vyges/sg13cmos5l_vyges_ip__pll_rosc/README.md

# sg13cmos5l_vyges_ip__pll_rosc

Ring-oscillator **PLL** for the IHP **SG13CMOS5L** process — a self-biased,
dual-control-path ring-VCO PLL with a register-selectable ÷N feedback divider.
**All-CMOS** (no SiGe HBT / MiM cap / deep-N-well / Schottky — none of which
SG13CMOS5L provides); the loop-filter cap is MOM/poly within the 5-metal stack.
Built for the **Chipalooza Challenge #2 (IHP SG13CMOS5L)** as an openframe
analog-slot IP.

> Status: **laid out and handed off to the harness (`gds/`); post-layout check done on the handed-off block.**
> The block is its own layout cell, instanced once in `gds/slot_6.gds`; both are DRC-, antenna- and
> LVS-clean on the PDK decks, with all control bits pinned, and the harness test build places it.
> Post-layout (extracted C, no wire R yet), phase margin passes (46.2° against 45°) and lock at
> the typical corner is 18 µs. The ring runs about 23 % slower than in the schematic, and lock at
> ss / −40 °C / 1.08 V is 24 µs against a 20 µs goal. Measured on the handed-off block itself
> (2026-10-19). See [`doc/implementation.md`](doc/implementation.md)
> for what is built and measured, and [`doc/proposal.md`](doc/proposal.md) for the original
> design intent.

PLL top level

The loop: a tri-state PFD (`Xup`/`Xdn`, reset through `Xnand`/`Xand`, held by `porb`) steers the
charge pump's switches `Mswup`/`Mswdn` between the current source `Mpsrc` and sink `Mnsnk`; the
pump drives `vctrl` into `Cp` and the `Rz`–`Cz` zero; `vctrl` sets the current-starved ring
`Xvco`, whose output returns through the ÷N divider `Xdiv`. The figures in
[`doc/figures/`](doc/figures/) are drawn from the xschem schematics and checked against them pin
by pin (the check tables are in that directory's README); the schematics in `xschem/` remain the
source of truth.

| PFD | Charge pump | Ring VCO: one stage, and the folded seven-stage ring |
| --- | --- | --- |
| PFD | Charge pump | Ring VCO |

## Summary

Measured on the schematic hierarchy and, post-layout, on the routed slot-6 layout with extracted
capacitance (no wire resistance yet), on the 1.2 V core rail this block is specified for.

| Parameter | Schematic | Post-layout | Goal |
| --- | --- | --- | --- |
| Digital supply (`vccd`) input | **1.08 / 1.20 / 1.32 V** — the 1.2 V ±10 % core rail, a hard input. Arrives on the block's `vdd` port. **Not** the 3.3 V pallet supply, which this block does not use | same | 1.08–1.32 V |
| Reference in | 16–50 MHz usable | 16–33 MHz at ÷8 guaranteed over PVT (ceiling ÷ 8) | 10–50 MHz |
| Output, typical corner | 115.4–735.3 MHz | 197.5–565.4 MHz | 100–800 MHz |
| Output, guaranteed over PVT | **352.6 MHz** ceiling, within charge-pump compliance | **267.1 MHz** | 800 MHz |
| Divider | ÷8 and ÷16 usable (÷2, ÷4 need a reference above 50 MHz) | same | N = 4…64 |
| Lock time, typical | **16.0 µs** (tt / 27 °C / 1.20 V) | **18 µs** ✅ | 20 µs max |
| Lock time, worst measured corner | **24.0 µs** ❌ (ss / −40 °C / 1.08 V) | **24 µs** ❌ | 20 µs max |
| Phase margin, N = 8 | **51.3°** ✅ (ff / 27 °C / 1.32 V / worst-case sheet) | **55.8°** ✅ | 45° min |
| Phase margin, N = 16 | **51.2°** ✅ (ss / 27 °C / 1.08 V / best-case sheet) | **46.2°** ✅ | 45° min |
| Crossover vs f_ref/10 | **1.20×** — exceeds the guideline | **1.01×** | ≤ 1.0 |
| Charge-pump current | **0.31–0.63 µA** measured, from the harness 250 nA reference | — | — |
| Loop filter | Rz 125.09 kΩ, Cz 8.65 pF (82 × 82 µm), Cp 0.33 pF (16 × 16 µm) | Cz 8.57 pF, Cp 0.33 pF extracted (−1 %) | — |

Every figure in this table is derived by `tools/datasheet.py`, which **exits non-zero if any
published number has drifted from the simulation behind it** — so the table cannot quietly go
stale. The post-layout column is checked against `doc/datasheet/pll_rosc_pex.md`, which the
same tool writes from the post-layout run (`--source pex --tree <run> --pexjson <pex_cells.json>`).
Post-layout lock time is sampled every 6 µs (48 µs window): typical lock lands between 12 and
18 µs, and the worst corner between 21 and 24 µs (a 24 µs run with 3 µs samples was still 9 % short at 21 µs). Detail, and what each miss costs, below.

## What it is

A foundational on-chip clock multiplier. Designed to drop into one openframe pallet slot —
**allocated slot 6, two pins**, which is exactly what it asks for: `ref` in and `vco_out` out.
It runs entirely from the **1.2 V core rail**, takes its bias from the harness 250 nA current
reference, and receives ÷N-select and its two resets as a register field on the digital
control-status bus. It needs **no 3.3 V analog rail**, and it reports no status: lock detect
is not implemented.

The loop figures come from a closed-loop run with every block real except the VCO, which is
behavioural and matched to the measured tuning curve of the real ring.

🔑 **The goals column is a goal, not a contract.** It was written before the PDK, the charge
pump's real output current and the supply's own tolerance could be modelled. They can be now,
and the measured column is what this design does on a 1.2 V rail. The output ceiling is the
clearest case: the ring reaches 735 MHz at the typical corner with the control voltage at the
top of the pump's compliance range, so 800 MHz guaranteed is not a margin that can be tuned
back — it is a property of a seven-stage ring on this process at this supply.

✅ **Phase margin passes at both divider settings**, 51.3° and 51.2° against a 45° floor,
over every operating point the part can be commanded into. Getting there needed two things
that had never been measured rather than any change to the oscillator:

- **The charge-pump current.** It was carried as 1 µA because the pump mirrors the harness
  bias 1:1. The mirror is 1:1 in *width*, not in drain-source voltage — measured over 27
  corners it delivered **1.16–2.26 µA**, so the loop ran at roughly twice the gain its filter
  was designed for. The block now takes the harness **250 nA** reference instead, measuring
  0.31–0.63 µA; required filter capacitance scales with it, so this also made the fix cheap
  (6,980 µm² of capacitor against 15,908 µm² at the 1 µA rail).
- **The top of the control range is not an operating point.** The pump's up branch runs out
  of compliance at about 0.85–0.91 × vdd and collapses to zero at the rail, so tuning-curve
  points above that cannot hold lock. The lowest Kvco in the whole sweep lives there, and it
  had been setting the phase-margin worst case.

📏 **Acquisition, per corner.** The bench models the ring behaviourally at one corner, so the
spread is measured explicitly rather than inferred — transistor-level, 100 ps over a 32 µs
window, at the corners with the lowest loop gain at the lock point:

| Corner | Lock time | |
| --- | --- | --- |
| tt / 27 °C / 1.20 V | 16 µs | ✅ |
| ss / 110 °C / 1.08 V | 16 µs | ✅ |
| ss / 27 °C / 1.08 V | 20 µs | ✅ at the limit |
| tt / −40 °C / 1.08 V | 20 µs | ✅ at the limit |
| **ss / −40 °C / 1.08 V** | **24 µs** | ❌ |

⛔ **One corner of the specified set misses the 20 µs goal** — cold, slow process, bottom of
the rail. At 20 µs it is still 3 % from its lock point, so this is a real miss and not a
sampling artifact. It is a direct consequence of bringing the loop inside its own bandwidth
bound: the previous 4 µs was fast *because* the crossover sat at twice the f_ref/10 it
claimed. Four corners were measured, not twenty-seven — each is a multi-hour transient, so
they were chosen by loop gain at the lock point and the rest are inference from them.

⚠️ **What is not met, stated here rather than left to be found.** The **output ceiling**,
above. The **divider range**, since only ÷8 and ÷16 are usable against a 16–50 MHz reference.
And the **crossover bound**: the loop's crossover reaches 1.20 × f_ref/10 at worst case
(N = 8, worst-case sheet, ff/27 °C/1.32 V), against the classical ≤ f_ref/10 guideline — 11 of
456 corner/point combinations exceed it, all at N = 8 and worst-case sheet resistance, by at
most 20 %. It is published as measured rather than bought back, because the only lever that
lowers it is a faster loop, and acquisition time is the tighter constraint. Six further
specifications — period and RMS jitter, phase noise, reference spur, duty cycle and power —
are **not measured**, for the one reason given in
[`doc/implementation.md`](doc/implementation.md). Lock detect and the output post-divider are
**not implemented**.

⛔ **Supply rails, because these have been conflated more than once.** **1.2 V is the core
rail and this block runs entirely from it** — ring, PFD, charge pump and divider are all lv
devices and 1.2 V standard cells. **3.3 V is the pallet supply** from the harness pMOS power
switch, and this block does not use it at all. The corner set is **1.08 / 1.20 / 1.32 V**,
which is what the PDK characterises (`sg13cmos5l_stdcell_*_1p08/1p20/1p32`); an earlier sweep
of 0.98 / 1.20 / 1.50 V was neither — 0.98 V is *below* the slowest characterised standard
cell, and 1.50 V is the other rail family's nominal. Detail and the traps that caused it:
[`doc/implementation.md`](doc/implementation.md).

## For the integrator

[`doc/implementation.md`](doc/implementation.md) carries two sections written for scoping
this block into a slot:

- **Supply rails** — which rail is which, why the corner set is 1.08/1.20/1.32 V, and the three ways 1.2 V and 3.3 V have been conflated here before.
- **Assumptions** — the process and harness resources the design rests on, each with what it is based on.
- **Slot requirements** — pads, harness resources, control bits and clocks. Two pads, one
  of them an up-to-735 MHz output that needs a dedicated path; the block runs entirely
  from 1.2 V, with **no 3.3 V analog rail required**.
- **Against the proposal** — every goal line with what the schematic measures, including the
  output range and divider range that fall short of it.

## Physical design

✅ **The layout is in [`gds/`](gds/).** Every device of the netlist is placed in the slot-6
floorplan ([`doc/implementation.md`](doc/implementation.md#floorplan--the-slot-6-placement-as-checked-data)).
The block is its own cell, `sg13cmos5l_vyges_ip__pll_rosc` (529.05 × 269 µm, pins named by its
ports), routed inside its own outline; `gds/slot_6.gds` instances it once in the harness slot,
with a straight stub from each wrapper pin it uses to the block pin facing it. On the PDK decks:

| Check | Block alone | In `slot_6` |
| --- | --- | --- |
| DRC (KLayout, main rules) | **0** | **0** |
| Antenna | **0** | **0** |
| LVS (KLayout, strict top-level ports) | **match** | **match** |
| Unused wrapper pins clear of our metal | — | **0 violations, 45 pins** |
| Density | fails at block level, as expected — chip-level fill is a harness step | |

In the harness's own test build, the slot is found and placed, its outline and every pin land on
the wrapper's (contract check PASS), and the slot as assembled into the chip is identical to
`gds/slot_6.gds` (XOR clean, 36 layers).

**Antenna diodes** (2026-10-18): `ref` and `porb` arrive from wrapper pins hundreds of µm away and
climb to TopMetal1, so the PFD gates they drive failed the antenna rule on Metal3, Metal4 and
TopMetal1 (12 markers). One `sg13cmos5l_antennanp` beside each gate, in the schematic and the PFD
region, clears all 12; the pad's ESD diode could not, because it joins only on Metal3.

`Rz` is drawn **straight** (1.40 × 89.22 µm). Folding it with the PDK's `rhigh` serpentine would
change what LVS extracts (per-segment `l`, bends, leg spacing) and the resistance itself.

**The ring is folded.** The first layout placed the seven stages in one row and wrapped it
partway through one stage, so one ring wire ran about 110 µm back across the block. The ring
now runs in two lanes, one column per stage, with each stage's load inverter in its own column,
so no ring wire spans more than about one column. Ring-node capacitance went from 2.1–12.3 fF to
an even 3.2–5.8 fF.

**Post-layout (capacitance only; wire resistance is not yet extracted):**

| | Schematic | First layout | Folded ring |
| --- | --- | --- | --- |
| Ring frequency, tt / 27 °C / 1.20 V, vctrl 0.80 V | 421.4 MHz | 296.0 MHz (−30 %) | 319.7 MHz (−24 %) |
| Worst phase margin, N = 16 (floor 45°) | 51.2° | ⛔ 44.4° | ✅ 46.0° |
| Lock at ss / −40 °C / 1.08 V (goal 20 µs) | 21.0 µs | ⛔ unreachable (control voltage above the pump's compliance) | ⛔ 21–24 µs |

The loop filter extracts within 1 % of the model, so the filter is not the cause. The rest of the
slowdown is the minimum wiring each ring node needs (about 4 fF against about 15 fF of device
load). The folded ring gets back enough of it to pass the phase-margin floor, with 1° to spare.

**Lock with the folded ring.** In a 48 µs run, the control voltage reaches its lock point
(0.891 V) at 24 µs and stays within 0.13 % of it to the end. In a 24 µs run sampled every 3 µs,
it is still 9 % short at 21 µs. So lock lands between 21 and 24 µs, and it misses the 20 µs goal
at this corner. The schematic misses too: 21.0 µs on the same 3 µs grid, and 24 µs in its own
32 µs run (see Acquisition, per corner). The miss comes from the loop sizing; the layout makes it
slightly worse. Closing it means faster loop dynamics, which costs phase margin, and post-layout
margin is now 46.0° against a 45° floor. So it is a spec decision, not a layout fix: either relax
lock time at cold, slow process, low rail, or retune the loop and re-check phase margin.

Open items:

- ✅ **Post-layout check re-run on the handed-off block (2026-10-19).** Giving the block its own
  outline moved the routing grid, so every net was re-routed (same placement, wire length 5585
  against 5575 µm). The table above is that block's: phase margin 55.8° (÷8) and 46.2° (÷16),
  tuning 197.5–565.4 MHz typical, lock 18 µs typical and 24 µs at ss / −40 °C / 1.08 V.
- ⚠️ **The PFD's antenna diodes needed a simulation workaround.** The PDK's `dantenna` model
  aborts a transient under a clock edge
  ([IHP-Open-PDK#1288](https://github.com/IHP-GmbH/IHP-Open-PDK/issues/1288)). The cause, per the
  maintainer, is the soft-breakdown fit: `nbv` ≈ 49 makes the reverse current jump about 160× at
  3·n·kT/q (78 mV at 27 °C), and the model's 700 ns transit time amplifies the jump.
  - **Workaround:** the PFD benches include a copy of the PDK's `diodes.lib` with the transit time
    and the 0.36 MΩ series resistance removed (`sim/diodes_rev.sh`).
  - **Why it is safe:** the diodes stay reverse-biased, where neither parameter does anything. The
    lock bench agrees with the same bench run without the diodes to 0.8 mV of `vctrl` at every
    sample.
  - **Upstream's fix agrees:** the maintainer's breakdown fix gives the same result as this
    workaround, within 0.5 mV, wherever both run.
- ⛔ Lock at ss / −40 °C / 1.08 V misses 20 µs (a spec decision). Then the same check with wire resistance extracted.
- ✅ **Control bits pinned (2026-10-08):** `nsel0` → `dig_in[0]`, `nsel1` → `dig_in[2]`,
  `rstb` → `dig_in[4]`, `porb` → `dig_in[6]` of slot 6's own 24-bit `dig_in` bus. Every other
  bit is used, so the router has a gap to reach each 0.22 µm pin. The wrapper's unused pins go to
  the router as blockages and are checked after routing. Routed DRC 0, LVS match. If the bits
  power up at 0, `porb` and `rstb` hold the phase detector and divider in reset until software
  releases them.
- ⚠️ `vco_out` keeps its analog pad, and an on-slot output divider is added (decided
  2026-10-05). The divider is not drawn yet.
- ℹ️ In the taped-out layout the rails are routed as ordinary nets. The supply grid is on the
  `layout-refine` branch (below).

### Layout refinement (branch `layout-refine`, in progress)

The tables above describe the taped-out layout (tag `tapeout-2026-10`). This branch carries the
items from the layout review. Its numbers are short checks only; the full post-layout gate runs
once the refinements are done.

- **Supply grid.** vdd and vss run as TopMetal1 bands over Metal4 fingers, fed from spines at the
  block edges. Each supply terminal is joined to its band by a drawn via stack instead of being
  left to the router.
- **Tie cell.** The PFD flops' D inputs are driven by a tie-high cell (`dhi`), not the vdd rail.
  With the grid on vdd, those two gates were the only gate area on a net with thousands of µm² of
  metal, and the antenna rule failed.
- **Guard rings.** Every analog region has a p+ substrate ring; the charge pump and the VCO also
  have an n+ well ring.
- **Compaction.** The regions take 11.5 % of the slot (was about 22 %). The VCO's fold is
  mirrored so that its output end (X1, X7 and the output buffer) sits by the `vco_out` pad;
  before, the buffer was about 230 µm from it.

Short check (tt / 27 °C / 1.20 V; capacitance only): DRC 0, antenna 0, LVS match, keepouts 0. The
tuning curve tops out at 539.9 MHz against 565.4 MHz for the taped-out layout (−4.5 %): ring nodes
n2–n5 each gained 0.8–1 fF of routed Metal3. Drawing the ring wiring by hand is the next step for
that.

**What routing needed that the PDK cells do not provide:** a gate contact on every MOSFET, a well
tap on every pMOS, a substrate tie beside every nMOS (LU.b), and short Metal4 stubs to bring
each MOM capacitor's minimum-width terminal pins out of a cell that fills Metal1–Metal4.
Reported upstream as [IHP-Open-PDK#1267](https://github.com/IHP-GmbH/IHP-Open-PDK/issues/1267);
newer PDK versions add a guard-ring option that covers the taps and ties.

## Layout

| Dir | Contents |
| --- | --- |
| `xschem/` | schematics — `cs_inv`, `rosc_vco`, `pfd`, `charge_pump`, `loop_filter`, `divn`, `pll_rosc` |
| `doc/schematics/` | rendered SVGs of every cell, readable without opening xschem |
| `gds/` | the layout: block cell `sg13cmos5l_vyges_ip__pll_rosc` and the harness hand-off `slot_6.gds` |
| `doc/figures/` | presentation circuit figures (cirfig_gen), each checked pin by pin against the schematic |
| `netlist/` | extracted / simulation netlists |
| `sim/` | testbenches — **`sim/ringvco_feasibility.spice`** + `run_tuning_sweep.sh` |
| `verilog/` | digital control/status wrapper (LibreLane) |
| `signoff/` | DRC / LVS / extract / STA reports |
| `doc/` | design notes, characterization |

## Toolchain

IHP open flow: **xschem / ngspice / magic / netgen / klayout** + **LibreLane**
for digital. ngspice must support **OSDI v0.4** (the IHP PSP103 models —
SG13CMOS5L shares them with SG13G2) — use IIC-OSIC-TOOLS or ngspice ≥ 43.

[**Vyges Loom**](https://vyges.com/products/loom) provides independent sign-off
alongside it — `vyges loom lvs` gates connectivity against a known-good netlist,
`vyges loom extract` supplies parasitics once there is layout, and `vyges loom meas`
measures swept transfers. Each exits non-zero on a violation, so they run as build
gates. Install: <https://docs.vyges.com/installation.html>. Commands and results are
in [`doc/implementation.md`](doc/implementation.md).

## Reproducing the results

`sim/run.sh` netlists the schematic hierarchy and runs every testbench from a clean
clone. It needs xschem, ngspice, and the IHP PDK — **one checkout now covers both halves**,
since upstream merged the `ihp-sg13cmos5l` overlay into IHP-Open-PDK:

```sh
git clone --branch dev --recurse-submodules https://github.com/IHP-GmbH/IHP-Open-PDK.git
git -C IHP-Open-PDK checkout ab1510cbdcbd61fe82e24ec28179c02ea7083299
PDK_ROOT=$PWD/IHP-Open-PDK python3 IHP-Open-PDK/ihp-sg13g2/libs.tech/ngspice/install.py
PDK_ROOT=$PWD/IHP-Open-PDK PDK=ihp-sg13cmos5l sh sim/run.sh
```

`--recurse-submodules` is not optional, and `install.py` compiles the Verilog-A models
(`psp103`, `psp103_nqs`, `r3_cmc`, `mosvar`) that ship as sources rather than binaries.

⚠️ **One upstream gap to work around.** Both `.spiceinit` files load all six OSDI models
from `$PDK_ROOT/$PDK/libs.tech/ngspice/osdi/`, but `install.py` writes its four only into
`ihp-sg13g2`, while `ihp-sg13cmos5l` ships only the other two (`cap_cmomf`, `cap_cmomi`)
prebuilt. Neither directory holds all six, so whichever `$PDK` you select the elaboration
fails on the missing pair. Symlink the two sets into each other after installing.

`$PDK_ROOT` defaults to `/foss/pdks` (what IIC-OSIC-TOOLS sets) and `$PDK` to
`ihp-sg13g2`, so the bundled PDK still works — but it is the *old* two-repository pin and
will not reproduce the numbers above.

⛔ **A PDK missing `cap_cmomf` does not fail — it silently drops every capacitor.** For a
symbol it cannot resolve, xschem writes `*  Cz -  cap_cmomf  IS MISSING !!!!` as a
*comment*: the netlist stays syntactically valid and simulates. The IIC-OSIC-TOOLS bundled
PDK still ships the pre-rename `cap_mfringe` and no `cap_cmomf` at all, so the loop filter
netlists against it as a bare resistor with both capacitors gone. ⟹ Grep a fresh netlist for
`IS MISSING` before trusting anything derived from it.

Apache-2.0. See [`NOTICE`](NOTICE) for attribution.
