vyges/sg13cmos5l_vyges_ip__pll_rosc/gds/README.md

# Layout

| File | Top cell | Size (µm) | What it is |
| --- | --- | --- | --- |
| `sg13cmos5l_vyges_ip__pll_rosc.gds` | `sg13cmos5l_vyges_ip__pll_rosc` | 529.05 × 269.00 | The PLL as a reusable block: its own prBoundary, pins named by its ports (`ref`, `vco_out`, `ibias`, `nsel0`, `nsel1`, `rstb`, `porb`, `vdd`, `vss`) |
| `slot_6.gds` | `slot_6` | 537.15 × 273.00 | The Chipalooza slot 6 hand-off: one instance of the block at (4, 2), the wrapper pins it uses, and a straight stub from each to the block pin facing it |

This is the `layout-refine` layout (2026-10-26): supply grid, guard rings, compaction and the mirrored ring
fold. The taped-out layout (2026-10-18) is the one on `main`.

Checks on both files (2026-10-26, IHP-Open-PDK KLayout decks, block alone and in the slot):
DRC 0, antenna 0, LVS match, and every unused wrapper pin clear of our metal.
Generated by chipalooza `tools/slot_route_run.sh 6` from the xschem schematic in `xschem/`.
