vyges/sg13cmos5l_vyges_ip__pll_rosc/doc/figures/README.md

# PLL presentation figures

Last updated: 2026-10-18

Slide figures for `pll_rosc`, drawn with cirfig_gen (one SVG per figure, sized in pt; insert at
100 % and never resize). Each figure has its SVG, the editable JSON layout, and a PNG preview.

**These figures are drawn from descriptions. The xschem schematics in `xschem/` are the source of
truth.** The xschem exports in `doc/schematics/` are unchanged. Checked against the schematics at
commit `bfc61e8` (which added the `pfd` antenna cells).

| Figure | Size (pt) | What it shows |
|---|---|---|
| `pll_top.svg` | 885.46 x 412.01 | Loop: PFD (`Xup`, `Xdn`, `Xnand`, `Xand`), charge pump (`Mpsrc`, `Mswup` with its `up` inverter, `Mswdn`, `Mnsnk`), loop filter (`Rz`, `Cz`, `Cp`; the top instantiates `loop_filter`, not `loop_filter_lownoise`), ring VCO `Xvco`, divider `Xdiv`. |
| `pll_pfd.svg` | 402.32 x 260.86 | `pfd`: two DFFs with D tied high, clocked by ref and div; `rstb` = AND(NAND(up, dn), porb) resets both (active-low RESET_B). |
| `pll_cp.svg` | 508.61 x 325.06 | `charge_pump` transistor level: ibias mirror `Mn0`/`Mn1`/`Mnsnk`, `Mp0` -> `vbp` -> `Mpsrc`, switches `Mswup` (gate `upb` from `Mpi`/`Mni`) and `Mswdn` (gate dn) onto vctrl. |
| `pll_vco.svg` | 795.34 x 318.42 | Left: one current-starved stage `cs_inv` (`Mps`, `Mpu`, `Mnd`, `Mns`; shown as stage X1, in = n1, out = n2) with the shared bias `Mpr`/`Mnr` (vctrl -> vbp). Right: the 7-stage ring drawn folded (X1-X4 left to right, X5-X7 back), n1 tapped by `Xtap` (inv_1) and `Xbuf` (inv_4) to vco_out. |

## Drawing conventions

- The VDD symbol is `vdd`; the GND symbol is `vss`. Bulk terminals are not drawn (PMOS bulk vdd, NMOS bulk vss throughout).
- Terminal labels name schematic nets: REF=ref, DIV=div, UP=up, DN=dn, PORB=porb, VCTRL=vctrl, IBIAS=ibias,
  IN/OUT = the stage's in/out, VCOOUT=vco_out. The free labels `rstb`, `div` and `n1` name internal nets.
- The DFF symbol's R pin is the cell's active-low RESET_B. The cells' Q_N outputs (nets upn, dnn) connect
  to nothing in the schematic and are not drawn.
- Since `bfc61e8`, the PFD's D inputs are driven by a tie-high cell `Xtiehi` (node `dhi`), not the
  vdd rail. The flops still see a constant 1, and the figures show D tied high. The cell is in
  `doc/schematics/pfd.svg`.
- The folded ring follows the placement described in `doc/implementation.md` (X1-X4 one way, X5-X7 back); electrically it is the plain ring n1 -> X1 -> ... -> X7 -> n1.

## Simplifications

- `pll_top.svg`: the pump's `Mpsrc` and `Mnsnk` are drawn as current sources (they are the mirror outputs;
  the mirror `Mn0`/`Mn1`/`Mp0` and the ibias input are in `pll_cp.svg`); `Mpi`+`Mni` are drawn as one inverter.
  **`Xdiv` is drawn with the palette Buffer symbol as a stand-in**, labelled "1/N, N=2,4,8,16": the palette has
  no divider block, and the divider (four ripple DFFs with Q_N fed back to D, plus a mux4 selecting the tap)
  cannot be drawn at cell level without a crossing per stage. Its rstb, nsel0 and nsel1 inputs are not drawn.
  The VCO uses the palette Ring Oscillator icon, which has no leads: vctrl ends on the ring's left point and
  vco_out leaves its bottom point, so both wires cross the icon's tinted margin.
- `pll_top.svg` has two wire crossings (no dots), both in the PFD reset loop: once the PFD outputs continue
  into the pump, `rstb` cannot reach both RESET_B pins without crossing the dn line once and the lower NAND
  input tap once. `pll_pfd.svg` on its own has no crossings.
- Not drawn: the antenna-protection cells `Xantref` (on ref) and `Xantporb` (on porb) in `pfd`, and the
  six matched dummy inverters `Xdum2`-`Xdum7` (inv_1 on n2-n7, outputs open) in `rosc_vco`.

## Verification

Each table below was generated by extracting connectivity from the `.sch` geometry (instance pin
positions from the PDK/local symbols, nets from the xschem wire labels; hierarchical figures are checked
against the top schematic flattened one level) and comparing it, pin by pin, with the connectivity of
the figure's own wires. The same extractor reproduces the LDO's xschem netlists exactly. A figure passes
only when every drawn pin lands on the schematic net, no figure net joins two schematic nets, no
schematic net is split (except supplies), and every schematic device is either drawn or listed as not
drawn. A drawn symbol that stands for several devices is checked on its ports, as a pseudo-device:
`Xcp/Mpi+Mni` (A=up, Y=upb), `Xvco` (vctrl in, vco_out out), `Xdiv` (clk in, div_out out).

Render check (`tools/render.py`): every figure reports "all wire ends on pins or wires".

#### Check: pll_top.svg vs xschem/pll_rosc.sch (flattened one level)

Devices: schematic 45 instances (flattened one level, including the hierarchy wrappers), drawn 14 symbols, three of which stand for device groups (the pump inverter = Mpi+Mni; Xvco; Xdiv); not drawn: Xpfd (wrapper); Xpfd/Xantref (antenna cell on ref); Xpfd/Xantporb (antenna cell on porb); Xcp (wrapper); Xcp/Mn0 (ibias mirror (in pll_cp.svg)); Xcp/Mn1 (ibias mirror); Xcp/Mp0 (ibias mirror); Xcp/Mpi (drawn as the inverter); Xcp/Mni (drawn as the inverter); Xlf (wrapper); Xvco/ (ring internals, in pll_vco.svg); Xdiv/ (divider internals (4 ripple DFFs + mux4), shown as one stand-in symbol).

| Figure symbol | Schematic device | Pin | Schematic net | Figure net | Match |
|---|---|---|---|---|---|
| Xup | Xpfd/Xup | D | vdd | VDD symbol | yes |
| Xup | Xpfd/Xup | CLK | ref | REF (terminal) | yes |
| Xup | Xpfd/Xup | Q | up | internal node | yes |
| Xup | Xpfd/Xup | RESET_B | Xpfd/rstb | internal node | yes |
| Xdn | Xpfd/Xdn | D | vdd | VDD symbol | yes |
| Xdn | Xpfd/Xdn | CLK | div_out | internal node | yes |
| Xdn | Xpfd/Xdn | Q | dn | internal node | yes |
| Xdn | Xpfd/Xdn | RESET_B | Xpfd/rstb | internal node | yes |
| Xnand | Xpfd/Xnand | A | up | internal node | yes |
| Xnand | Xpfd/Xnand | B | dn | internal node | yes |
| Xnand | Xpfd/Xnand | Y | Xpfd/nout | internal node | yes |
| Xand | Xpfd/Xand | B | porb | PORB (terminal) | yes |
| Xand | Xpfd/Xand | A | Xpfd/nout | internal node | yes |
| Xand | Xpfd/Xand | X | Xpfd/rstb | internal node | yes |
| Xcpinv | Xcp/Mpi+Mni | A | up | internal node | yes |
| Xcpinv | Xcp/Mpi+Mni | Y | Xcp/upb | internal node | yes |
| Mswup | Xcp/Mswup | G | Xcp/upb | internal node | yes |
| Mswup | Xcp/Mswup | D | vctrl | internal node | yes |
| Mswup | Xcp/Mswup | S | Xcp/a | internal node | yes |
| Mswdn | Xcp/Mswdn | G | dn | internal node | yes |
| Mswdn | Xcp/Mswdn | D | vctrl | internal node | yes |
| Mswdn | Xcp/Mswdn | S | Xcp/b | internal node | yes |
| Ipsrc | Xcp/Mpsrc | S | vdd | VDD symbol | yes |
| Ipsrc | Xcp/Mpsrc | D | Xcp/a | internal node | yes |
| Insnk | Xcp/Mnsnk | D | Xcp/b | internal node | yes |
| Insnk | Xcp/Mnsnk | S | vss | GND symbol | yes |
| Rz | Xlf/Rz | P | vctrl | internal node | yes |
| Rz | Xlf/Rz | M | Xlf/nz | internal node | yes |
| Cz | Xlf/Cz | c0 | Xlf/nz | internal node | yes |
| Cz | Xlf/Cz | c1 | vss | GND symbol | yes |
| Cp | Xlf/Cp | c0 | vctrl | internal node | yes |
| Cp | Xlf/Cp | c1 | vss | GND symbol | yes |
| Xvco | Xvco | vctrl | vctrl | internal node | yes |
| Xvco | Xvco | vco_out | vco_out | VCOOUT (terminal) | yes |
| Xdiv | Xdiv | clk | vco_out | VCOOUT (terminal) | yes |
| Xdiv | Xdiv | div_out | div_out | internal node | yes |

Net check: PASS

#### Check: pll_pfd.svg vs xschem/pfd.sch

Devices: schematic 6, drawn 4; not drawn: Xantref (antenna-protection cell on ref, not drawn); Xantporb (antenna-protection cell on porb, not drawn).

| Figure symbol | Schematic device | Pin | Schematic net | Figure net | Match |
|---|---|---|---|---|---|
| Xup | Xup | D | vdd | VDD symbol | yes |
| Xup | Xup | CLK | ref | REF (terminal) | yes |
| Xup | Xup | Q | up | UP (terminal) | yes |
| Xup | Xup | RESET_B | rstb | internal node | yes |
| Xdn | Xdn | D | vdd | VDD symbol | yes |
| Xdn | Xdn | CLK | div | DIV (terminal) | yes |
| Xdn | Xdn | Q | dn | DN (terminal) | yes |
| Xdn | Xdn | RESET_B | rstb | internal node | yes |
| Xnand | Xnand | A | up | UP (terminal) | yes |
| Xnand | Xnand | B | dn | DN (terminal) | yes |
| Xnand | Xnand | Y | nout | internal node | yes |
| Xand | Xand | B | porb | PORB (terminal) | yes |
| Xand | Xand | A | nout | internal node | yes |
| Xand | Xand | X | rstb | internal node | yes |

Net check: PASS

#### Check: pll_cp.svg vs xschem/charge_pump.sch

Devices: schematic 9, drawn 9.

| Figure symbol | Schematic device | Pin | Schematic net | Figure net | Match |
|---|---|---|---|---|---|
| Mpsrc | Mpsrc | G | vbp | internal node | yes |
| Mpsrc | Mpsrc | D | a | internal node | yes |
| Mpsrc | Mpsrc | S | vdd | VDD symbol | yes |
| Mswup | Mswup | G | upb | internal node | yes |
| Mswup | Mswup | D | vctrl | VCTRL (terminal) | yes |
| Mswup | Mswup | S | a | internal node | yes |
| Mswdn | Mswdn | G | dn | DN (terminal) | yes |
| Mswdn | Mswdn | D | vctrl | VCTRL (terminal) | yes |
| Mswdn | Mswdn | S | b | internal node | yes |
| Mnsnk | Mnsnk | G | ibias | IBIAS (terminal) | yes |
| Mnsnk | Mnsnk | D | b | internal node | yes |
| Mnsnk | Mnsnk | S | vss | GND symbol | yes |
| Mn0 | Mn0 | G | ibias | IBIAS (terminal) | yes |
| Mn0 | Mn0 | D | ibias | IBIAS (terminal) | yes |
| Mn0 | Mn0 | S | vss | GND symbol | yes |
| Mn1 | Mn1 | G | ibias | IBIAS (terminal) | yes |
| Mn1 | Mn1 | D | vbp | internal node | yes |
| Mn1 | Mn1 | S | vss | GND symbol | yes |
| Mp0 | Mp0 | G | vbp | internal node | yes |
| Mp0 | Mp0 | D | vbp | internal node | yes |
| Mp0 | Mp0 | S | vdd | VDD symbol | yes |
| Mpi | Mpi | G | up | UP (terminal) | yes |
| Mpi | Mpi | D | upb | internal node | yes |
| Mpi | Mpi | S | vdd | VDD symbol | yes |
| Mni | Mni | G | up | UP (terminal) | yes |
| Mni | Mni | D | upb | internal node | yes |
| Mni | Mni | S | vss | GND symbol | yes |

Net check: PASS

#### Check: pll_vco.svg left half (stage X1 + bias) vs xschem/rosc_vco.sch + cs_inv.sch

Devices: schematic 45, drawn 6; not drawn: X1 (stage wrapper; the ring is drawn on the right); X2 (stage wrapper; the ring is drawn on the right); X3 (stage wrapper; the ring is drawn on the right); X4 (stage wrapper; the ring is drawn on the right); X5 (stage wrapper; the ring is drawn on the right); X6 (stage wrapper; the ring is drawn on the right); X7 (stage wrapper; the ring is drawn on the right); X2/ (identical cs_inv stage); X3/ (identical cs_inv stage); X4/ (identical cs_inv stage); X5/ (identical cs_inv stage); X6/ (identical cs_inv stage); X7/ (identical cs_inv stage); Xtap (ring part); Xbuf (ring part); Xdum2 (dummy load); Xdum3 (dummy load); Xdum4 (dummy load); Xdum5 (dummy load); Xdum6 (dummy load); Xdum7 (dummy load).

| Figure symbol | Schematic device | Pin | Schematic net | Figure net | Match |
|---|---|---|---|---|---|
| Mpr | Mpr | G | vbp | internal node | yes |
| Mpr | Mpr | D | vbp | internal node | yes |
| Mpr | Mpr | S | vdd | VDD symbol | yes |
| Mnr | Mnr | G | vctrl | VCTRL (terminal) | yes |
| Mnr | Mnr | D | vbp | internal node | yes |
| Mnr | Mnr | S | vss | GND symbol | yes |
| Mps | X1/Mps | G | vbp | internal node | yes |
| Mps | X1/Mps | D | X1/nph | internal node | yes |
| Mps | X1/Mps | S | vdd | VDD symbol | yes |
| Mpu | X1/Mpu | G | n1 | IN (terminal) | yes |
| Mpu | X1/Mpu | D | n2 | OUT (terminal) | yes |
| Mpu | X1/Mpu | S | X1/nph | internal node | yes |
| Mnd | X1/Mnd | G | n1 | IN (terminal) | yes |
| Mnd | X1/Mnd | D | n2 | OUT (terminal) | yes |
| Mnd | X1/Mnd | S | X1/npl | internal node | yes |
| Mns | X1/Mns | G | vctrl | VCTRL (terminal) | yes |
| Mns | X1/Mns | D | X1/npl | internal node | yes |
| Mns | X1/Mns | S | vss | GND symbol | yes |

Net check: PASS

#### Check: pll_vco.svg right half (ring) vs xschem/rosc_vco.sch

Devices: schematic 17, drawn 9; not drawn: Mpr (drawn in the left half); Mnr (drawn in the left half); Xdum2 (matched dummy inverter on n2, output open; not drawn); Xdum3 (matched dummy inverter on n3, output open; not drawn); Xdum4 (matched dummy inverter on n4, output open; not drawn); Xdum5 (matched dummy inverter on n5, output open; not drawn); Xdum6 (matched dummy inverter on n6, output open; not drawn); Xdum7 (matched dummy inverter on n7, output open; not drawn).

| Figure symbol | Schematic device | Pin | Schematic net | Figure net | Match |
|---|---|---|---|---|---|
| X1 | X1 | in | n1 | internal node | yes |
| X1 | X1 | out | n2 | internal node | yes |
| X2 | X2 | in | n2 | internal node | yes |
| X2 | X2 | out | n3 | internal node | yes |
| X3 | X3 | in | n3 | internal node | yes |
| X3 | X3 | out | n4 | internal node | yes |
| X4 | X4 | in | n4 | internal node | yes |
| X4 | X4 | out | n5 | internal node | yes |
| X5 | X5 | in | n5 | internal node | yes |
| X5 | X5 | out | n6 | internal node | yes |
| X6 | X6 | in | n6 | internal node | yes |
| X6 | X6 | out | n7 | internal node | yes |
| X7 | X7 | in | n7 | internal node | yes |
| X7 | X7 | out | n1 | internal node | yes |
| Xtap | Xtap | A | n1 | internal node | yes |
| Xtap | Xtap | Y | vco_outn | internal node | yes |
| Xbuf | Xbuf | A | vco_outn | internal node | yes |
| Xbuf | Xbuf | Y | vco_out | VCOOUT (terminal) | yes |

Net check: PASS
