vyges/sg13cmos5l_vyges_ip__pll_rosc/doc/datasheet/pll_rosc_pex.md

# Datasheet for pll_rosc

**netlist source**: pex

| Parameter | Unit | Min Limit | Min Value | Typ Value | Max Limit | Max Value | Status |
| :--- | :--- | ---: | ---: | ---: | ---: | ---: | :----: |
| VCO tuning range, low | MHz | any | 197.527 MHz | 197.527 MHz | any | 197.527 MHz | Pass ✅ |
| VCO tuning range, high | MHz | 800.000 MHz | 565.360 MHz | 565.360 MHz | any | 565.360 MHz | Fail ❌ |
| Lock time | us | any | 18.000 us | 18.000 us | 20.000 us | 18.000 us | Pass ✅ |
| Output ceiling over PVT | MHz | 800.000 MHz | 267.100 MHz | 267.100 MHz | any | 267.100 MHz | Fail ❌ |
| Phase margin, N = 8 | deg | 45.000 deg | 55.826 deg | 55.826 deg | any | 55.826 deg | Pass ✅ |
| Phase margin, N = 16 | deg | 45.000 deg | 46.156 deg | 46.156 deg | any | 46.156 deg | Pass ✅ |
| Crossover, worst / (f_ref/10) | - | any | 1.014 | 1.014 | 1.000 | 1.014 | Fail ❌ |
| Lock time, worst corner | us | any | 24.000 us | 24.000 us | 20.000 us | 24.000 us | Fail ❌ |
| Area | um2 | any |  |  | 146641.950 um2 |  | Skip 🟧 |
| Magic DRC | - | any |  |  | 0.000 |  | Skip 🟧 |
| Netgen LVS | - | any |  |  | 0.000 |  | Skip 🟧 |
| KLayout DRC | - | any |  |  | 0.000 |  | Skip 🟧 |
| Antenna violations | - | any |  |  | 0.000 |  | Skip 🟧 |

---

© 2026 Vyges (https://vyges.com) · generated by `tools/datasheet.py`, do not edit by hand
