vyges/sg13cmos5l_vyges_ip__pll_rosc/doc/figures/pll_top.png

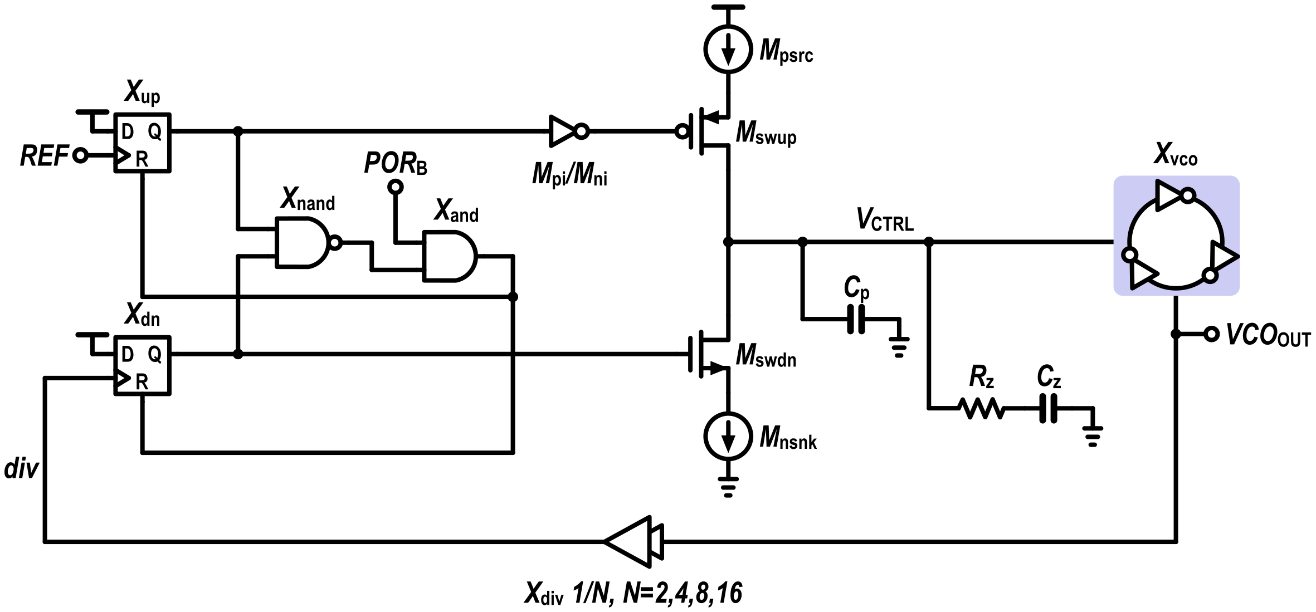
doc/figures/pll_top.png
