vyges/sg13cmos5l_vyges_ip__pll_rosc/(commit log)

2026-07-16 Initial commit: SG13G2 ring-osc PLL IP — Chipalooza proposal + feasibility
    Ring-oscillator PLL for IHP SG13CMOS5L (SG13G2), for the Chipalooza Challenge
    (IHP run). Skeleton (xschem/magic/netlist/sim/verilog/doc/signoff) + feasibility:
    a 5-stage ring VCO oscillates ~1.11-1.17 GHz (tt, 3.3V, 27C) in-process
    (IIC-OSIC-TOOLS: ngspice-46 + SG13G2 PDK, PSP103/OSDI); sg13_hv inverter trip
    1.465V. Deck + runner in sim/. Apache-2.0.
2026-07-16 Add current-starved VCO topology + analog flow doc
    - sim/ringvco_current_starved.spice: per-stage head/tail current-starved VCO
    with a vc->pbias mirror, for wide tuning (production VCO). WIP — correct
    topology, needs device-sizing/bias iteration to lock the range. The
    supply-starved feasibility ring already proves frequency capability.
    - doc/analog-flow.md: the IHP SG13G2 open-analog flow — IIC-OSIC-TOOLS
    container, ngspice/OSDI v0.4 setup, sg13_hv devices + corner include, the
    ring-osc startup kick, the full xschem/magic/netgen + LibreLane flow, and
    Loom independent sign-off. Captures the toolchain gotchas (apt ngspice too
    old for OSDI v0.4, stale github mirror, KiCad libn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
2026-07-16 rename to vyges-ring-oscillator-pll + CMOS5L-align README + add aligned proposal
    Repo renamed sg13cmos5l_vy_ip__ringpll -> vyges-ring-oscillator-pll (descriptive
    vyges branding, matches vyges-edge-sensor-soc). README reframed all-CMOS (no HBT/
    MiM/deepNW/Schottky; MOM/poly loop-filter cap; 5-metal) for Chipalooza #2
    (SG13CMOS5L). Add the aligned proposal at doc/proposal.md (per the rules the
    proposal becomes the IP repo documentation): CMOS-only architecture, I/O + test
    ports, target spec (min/typ/max/limits), harness resource list, test plan,
    review-gate milestones, CV kept out of the main doc. Feasibility (SG13G2 sg13_hv
    MOS) holds — CMOS5L shares those device models.
2026-07-17 doc: sync proposal with Tim Edwards answers (slot/bias/IO/control-contract)
2026-07-23 sync: submission-grade proposal + full sub-block prototype netlists
    Update doc/proposal.md to the final Chipalooza #2 submission version (all
    five sub-blocks demonstrated in-process, honest spec inside measured range,
    equipment-matched test plan) and add prototype/rosc-pll/ with the netlists
    section 7 references -- VCO tuning, div16, PFD, charge pump, and the
    behavioural closed-loop lock -- runnable from a clean clone.
2026-08-29 schematic: xschem hierarchy for the ring-oscillator PLL (Gate 1)
    Eight cells: cs_inv, rosc_vco, pfd, charge_pump, loop_filter, divn and the
    pll_rosc top level, plus loop_filter_lownoise.
    loop_filter_lownoise is a dual-path alternative to the RC baseline: the series
    resistor is replaced by a proportional voltage source in series with a small
    capacitor, so the capacitive divider reproduces the resistive step while noise
    injected by the voltage source is attenuated by the capacitor ratio instead of
    reaching the control node. Its integrating capacitor is a MOS cap held in
    inversion at 5x the minimum thick-oxide channel length -- far denser than MOM,
    and the only capacitor form this PDK models.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
    [charge_pump.sch, cs_inv.sch, divn.sch, loop_filter.sch, loop_filter_lownoise.sch, pfd.sch, pll_rosc.sch, rosc_vco.sch]
2026-08-29 doc: implementation record, rendered schematics, and NOTICE
    README moves from proposal status to schematic, and doc/implementation.md
    records what is built, what it measures against the prototype netlists, and
    what is deliberately not in this revision.
    doc/schematics/ holds an SVG of every cell plus a block diagram, so the design
    can be reviewed without installing xschem. The per-cell SVGs are rendered from
    the .sch files themselves, so the picture cannot drift from the netlisted
    circuit.
    Adds NOTICE for Apache-2.0 attribution: the IHP Open Source PDK supplies the
    device models, symbols and standard cells the schematics reference, and none of
    it is redistributed here.
2026-08-29 schematic: draw real wires between components in the PLL cells
    All eight cells are now routed rather than connected by matching net labels,
    so each schematic reads as a circuit: the bias mirror and steering branches in
    charge_pump, the flop pair and reset path in pfd, the seven-stage chain with
    its matched dummy loads in rosc_vco, and the loop from pfd through the pump and
    filter to the VCO and back through the divider at the top level.
    cs_inv puts bias and supplies on the vertical edges and signals on the
    horizontal ones. With vbp on the left edge it shared a height with out, so every
    stage-to-stage hop travelled along that line and shorted the bias into the ring.
    Two connections in divn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
    [charge_pump.sch, cs_inv.sch, divn.sch, loop_filter.sch, loop_filter_lownoise.sch, pfd.sch, pll_rosc.sch, rosc_vco.sch]
2026-08-29 doc: record the Loom commands and results used to verify this block
    Documents what was run, why, and what it returned: vyges loom lvs as a
    name-independent connectivity gate over the whole hierarchy, 60 nets matched by
    explicit isomorphism, with the deliberate-failure check alongside it -- shorting
    the charge pump up and dn inputs gives LVS MISMATCH and exit 3.
    States plainly what is NOT yet applicable and why, rather than listing engines
    that cannot run: meas needs a swept transfer or a coherent capture, neither of
    which this block has yet, and the gate-level engines need Liberty timing and
    switching activity that an analog block does not have.
    Notes why the gate earns its place here -- r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
2026-08-29 doc: use the vyges loom command form in the analog flow notes
    The Loom table still named the binaries as vyges-drc / vyges-lvs. Uses the
    vyges loom <engine> form throughout, adds a line on why each engine is run and
    at which stage, and links the product page and install guide. Also carries the
    markdown lint pass over the file.
2026-08-29 design: loop filter sized from the measured VCO tuning curve
    The filter values were round-number placeholders. Measuring the tuning curve on
    the loaded ring and designing against it replaces them:
    Icp 1 uA, Rz 80.8k, Cz 9.21 pF, Cp 0.75 pF.
    Worst-case phase margin is 48.6 degrees across every selectable operating point
    against a 45 degree minimum, with crossover below f_ref/10 everywhere. The
    previous placeholders gave 22.5 degrees and broke fc <= f_ref/10 at N=8.
    Two things move in this loop and both had to be covered: Kvco spans 349 to
    1653 MHz/V, a 4.7x spread, and N moves with the divider setting. Placing the
    zero and pole symmetrically about the crossover in log frequency, centred on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
    [loop_filter.sch]
2026-08-29 sim: closed-loop acquisition and PVT for the PLL
    The loop acquires and locks in roughly 5 microseconds at N=16 with a 16 MHz
    reference, settling at the control voltage that produces 256 MHz with a small
    overshoot and no ringing. The specification allows 20 microseconds. That run is
    at the highest-Kvco corner, so it is the most aggressive loop gain among the
    selectable settings.
    Everything in that loop is the real cell except the VCO, which is behavioural and
    matched to the measured tuning curve. A transistor-level ring has to be
    integrated at picosecond steps while the loop settles over microseconds, and a
    full transistor run reached 18 ns of a 30 microsecond target.
    PVT measures the tunin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
2026-08-29 doc: bring the PLL record in line with the measured design
    README moves from preliminary targets to measured values with the specification
    alongside, and states plainly that the 1 GHz ceiling is not met: 737 MHz at the
    typical corner, 600 MHz over PVT with the control voltage already at the rail.
    Removes a stale action -- the tuning curve "must be re-measured with the tap in
    place" -- which has since been done, and points at the measured curve instead.
    Notes on the cell table that only the divide-by-8 and divide-by-16 taps are
    usable with a reference in the specified range.
    Block diagram carries the designed filter values, the measured output band and
    the usable reference range rather than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
2026-08-30 doc: LVS gate now covers device sizing, not only connectivity
    Records the second deliberate-failure check alongside the connectivity one: a
    re-sized loop filter with untouched topology also fails, naming each device and
    both values. Notes that sizing comparison needs a build newer than v0.1.33.
2026-08-30 doc: compare against the proposal, and set out slot requirements
    Records every proposal line against what the schematic measures. Passing: lock
    time at ~5 us against a 20 us limit, phase margin over PVT, temperature range,
    digital supply. Failing or short: output range, divider range, the output
    post-divider, and six lines that are simply not measured -- jitter, phase noise,
    reference spur, duty cycle, power and lock detect.
    Notes that the analog 3.3 V rail the proposal assumed is not used at all: the
    block runs entirely from 1.2 V. That is one fewer supply into the slot and the
    integrator should hear it from us.
    Adds a slot-requirements section for pin scoping: two pads, one of which is a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
2026-08-30 doc: point the integrator at the slot-requirements and comparison sections
2026-08-30 doc: state the assumptions the design rests on
    Adds an Assumptions section covering the process, slot supply and harness
    resources with the basis for each.
    The load-bearing one is stated plainly: the whole block runs from 1.2 V while the
    slot supply is 3.3 V. The ring oscillator, phase detector, charge pump and
    divider are lv devices and 1.2 V standard cells, and the standard cells are
    characterised 1.08 to 1.65 V so they cannot be operated from 3.3 V. If no 1.2 V
    rail reaches the pallet the block has no supply. Notes that rebuilding in hv
    devices is not a port, since the ring delay per stage and therefore the whole
    tuning curve is a function of the supply.
    Also records what does line up: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
2026-08-30 sim: fix two measurements that silently returned nothing
    tb_pll_lock sampled v(ph) at t=30us, a leftover from an earlier 30us target, while the
    transient stops at 8us; ngspice reported out of interval, left the variable unset and
    still exited zero. The sample is now at 6us, which is what its name says.
    tb_vco_sweep measured four whole periods in a flat 600ns window. The ring is slowest at
    the bottom of its range, so at 0.40V the window could not hold four periods even though
    the ring was oscillating with full swing. The window is now per control point, and swing
    is measured first so a point below the start-up threshold is reported as a result rather
    than as a failed measurement.
2026-08-30 doc: work remaining and the questions that block layout
    Orders the outstanding work and separates the four questions that need answers from
    outside the block -- chiefly whether 600 MHz guaranteed is acceptable against a 1 GHz
    specification, and whether a 1.2 V rail reaches the pallets at all.
2026-08-30 pll: phase margin was computed from a nominal loop resistor at every corner
    Rz is an rhigh poly resistor with plus/minus 25 percent corners on this PDK pin, and it
    sets both the loop zero and the filter high-frequency gain. The corner sweep measured the
    VCO tuning curve and the phase margin was then computed from nominal Rz, so the resistor
    corner never entered the answer at all.
    Swept properly, worst case is 38.4 deg at ff/-40C with N=8 and worst-case sheet, against a
    45 deg minimum. The block does not meet its phase-margin specification. The 45.6 deg
    previously reported is the typical-sheet column of that table.
    Raising Rz lowers the zero but raises the filter high-frequency gain and pus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
2026-08-30 doc: record the PDK pin -- both trees, since both are needed
    Same two-repository structure as the LDO: the MOS and resistor corner models resolve to the
    sibling sg13g2 tree, not to the sg13cmos5l overlay this document previously cited. The
    resistor corner is what sets this block worst-case phase margin, so the pin that governs it
    is the one that was missing.
2026-08-31 sim: make run.sh reproduce from a clean clone
    run.sh could not run a single bench. tb_pll_lock.spice includes
    pll_cells.spice -- the sub-cell .subckt definitions extracted from the
    TOP-LEVEL netlist, because xschem comments out a cells own .subckt line
    when that cell is the top, so including a standalone cell netlist puts its
    devices at top scope instead of defining a subcircuit. The bench documents
    this at the include. The extraction step only ever existed in a private
    runner, so a clean clone stopped at
    Error: Could not find include file pll_cells.spice
    on the first bench. It is built here now, where the benches that need it
    can get it, and the script fails loudly if no .subckt comes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
2026-09-01 doc: correct the published phase margin, and stop advertising an unimplemented feature
    Four corrections, all of them places where the README or the summary text no longer
    matched the measurements further down implementation.md.
    - Phase margin: the README published 45.6 deg against a 45 deg minimum, i.e. a pass.
    That is the res_typ column of the very table implementation.md corrects. Rz is an
    rhigh whose corners on this PDK pin are +/-25 percent, and it sets both the loop
    zero and the filter's high-frequency gain; swept, the worst case is 38.4 deg at
    N = 8, which is a fail. The table now carries both N = 16 (49.5 deg, passes) and
    N = 8 (38.4 deg, does not).
    - The opening sentence d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
2026-09-01 sim: take the PDK location from $PDK_ROOT instead of a fixed path
    Every testbench, corner template, xschemrc and prototype deck hard-coded
    /foss/pdks, so the repository could only be reproduced inside one container
    layout. They now reference $PDK_ROOT, which ngspice expands itself in
    .include and .lib paths; the run scripts default it to /foss/pdks and export
    it. The bare form is required -- ngspice reads ${PDK_ROOT} as a variable
    literally named {PDK_ROOT} and fails.
    Both IHP PDKs have to sit under that one root, which the netlists never
    showed. The models and stdcells come from the ihp-sg13cmos5l overlay, but
    the compiled OSDI models come from the ihp-sg13g2 base, reached through the
    PDK'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
2026-09-01 re-pin to IHP-Open-PDK dev@ab1510c: phase margin at N=8 now passes
    Upstream merged the SG13CMOS-5L overlay into IHP-Open-PDK (PR #1124), so base and
    overlay are one tree under one commit. Worst-case phase margin at N=8 goes from
    38.4 to 49.3 degrees against a 45 degree minimum. No geometry changed.
    Two changes in that pin contribute, each evaluated on its own by holding the
    other at the old value rather than by splitting the total:
    rhigh corners re-aligned and the -0.04 um width correction removed, worst-case
    Rz 110.1 to 96.6 kohm +4.1 deg
    cap_mfringe renamed cap_cmomf, density recalibrated 2.32 to 1.287
    fF/um2, so Cz falls 9.21 to 5.11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
    [loop_filter.sch, loop_filter_lownoise.sch]
2026-09-02 datasheet: plots, so the margins are visible and not just asserted
    The reference datasheet the challenge points at carries figures alongside its table, and
    they earn their place here. Three, each showing something a row cannot: the typical
    tuning curve against the 800 MHz line it misses, so the headline shortfall is a distance
    rather than a claim; all nine corner curves, because the typical curve is not what the
    part guarantees and the 600 MHz ceiling comes from the slowest corner; and phase margin
    across every Kvco and resistor corner for BOTH divider settings, because their worst
    corners are opposite ones and a single-N plot would imply margin moves one way with
    corner when it does not.
    E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
2026-09-02 datasheet: render schematics here too, and a footer on the generated sheet
    sch2svg.py and its sym_art.json symbol cache move in from private tooling, for the same
    reason the numbers did: a published figure whose generator is private cannot be
    re-derived by the person reading it. The block now ships everything that made its
    datasheet, drawings included.
    It caught stale figures immediately: loop_filter and loop_filter_lownoise were last
    rendered before the dev@ab1510c re-pin, so the published drawings showed the earlier
    circuit. Regenerated.
    The sheet ends with an attribution footer whose year comes from the clock at emit time
    rather than being typed in - a constant someone has to remember t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
2026-09-02 sim: $PDK may be either variant now, and say why it could not be before
    The CMOS5L migration into IHP-Open-PDK changed something this header asserted. It said
    $PDK must be the sg13g2 base, because before the merge neither directory held all six
    compiled OSDI models - the base had four and the overlay the other two, so whichever one
    $PDK named, something failed to load.
    The overlay now carries all six: two of its own and four symlinked into the base. They
    resolve because base and overlay are siblings in one tree, which is what the merge did and
    what upstream means by "use $PDK to switch between the PDKs". Verified at dev@17dc8dc -
    PDK=ihp-sg13cmos5l runs this suite with no OSDI errors and me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
2026-09-02 doc: five of the six pre-layout questions are answered; say so
    Items 2 and 3 were already marked answered here, but 1, 4 and 5 were not, and item 6 had
    changed shape. Listing answered questions as open misrepresents the block to whoever reads
    it next.
    The answers: 600 MHz guaranteed is accepted. A 1.2 V rail IS distributed - this was the
    design-breaking one, since without a low rail the block needed a regulator in front of it.
    And behavioural jitter numbers are acceptable because SIMULATING them is not realistic:
    ngspice has no proper PSS, so the validation route is measurement.
    Question 1 also carried a wrong number and it is worth naming: it asked "against a
    specification of 1 GHz" when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
2026-09-02 pll: sweep the supply, and the guaranteed ceiling drops 40 per cent
    The review asked for the corner set to be restated in the 1.2 V domain rather than the
    proposal's 3.0/3.3/3.6. Looking at it, the problem was worse than a wrong table:
    tb_vco_pvt.tpl pinned the rail at exactly 1.2 V, so 27 PVT corners never once exercised the
    supply this block runs entirely from. The sweep now crosses 0.98 / 1.20 / 1.50 V with
    process, temperature and control voltage - 81 points, no failures.
    The guaranteed ceiling is set by the slowest corner, and the slowest corner sits at the
    bottom of the rail:
    0.98 V 359.2 MHz guaranteed 656.0 best
    1.20 V 599.5 MHz 903.8
    1.50 V 806.6 M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
2026-09-17 doc: per-cell connectivity results, and the PDK gap that empties a netlist
    All eight cells pass a connectivity pass over their own netlists. The two classes
    of deliberate single-connection net are declared with their reasons rather than
    silenced wholesale: ndum2..7, the matched dummy inverter each ring stage carries
    so the tapped stage is not the only loaded one, and upn/dnn, the Q_N pins of the
    up and dn flops.
    Records why it runs per cell - a .subckt slice of the top netlist covers only what
    the top instantiates, leaving out loop_filter_lownoise and pll_rosc itself - and
    the trap ahead of it: xschem writes an unresolvable symbol as a comment, so a
    netlist built against a PDK without cap_c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
2026-09-17 sim: sweep the control voltage as a fraction of the rail, and N=16 misses
    Vdd and Vctrl were independent sources crossed fully, but the charge pump's
    PMOS sources sit on the same single vdd net as the ring, so vctrl <= vdd
    always. The 0.98 V ceiling had been read at vctrl = 1.20 V, above its own
    supply and unreachable by the loop; the 1.50 V rail was never probed above
    1.20 V and was understated. Control is now 0.5833/0.6667/1.0 x vdd, which
    reproduces 0.70/0.80/1.20 V exactly at the nominal rail - those 27 rows came
    back byte-identical, so the pairing is the only thing that moved.
    Guaranteed ceiling: 318.3 MHz at 0.98 V (was 359.2), 599.5 at 1.20 V
    (unchanged), 910.5 at 1.50 V (was 806.6).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
2026-09-18 sim: seven control points per rail, in parallel, and a sweep that cannot half-report
    Three changes to the tuning sweep, each with its own reason.
    SEVEN FRACTIONS. Three control points per rail give two slopes, and the phase
    margin derivation took only the lowest pair, on the assumption that the worst
    case for a loop is the steepest part of the tuning curve. That is wrong for a
    type-II loop: it loses margin at BOTH ends of the gain spread, and the low-gain
    end is the FLAT TOP of this ring curve. The old sweep could not resolve it.
    0.5833/0.6667/1.0 are retained exactly, so every previously published row is
    still a row here.
    PARALLEL. 189 points serially is an hour and a quarter, which is lo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
2026-09-18 sim: measure the charge-pump current, which had only ever been asserted
    Every loop figure this block publishes is computed from Icp = 1 uA, justified
    as mirrored 1:1 from the harness bias. The mirror is 1:1 in WIDTH. It is not
    1:1 in drain-source voltage: the diode-connected reference sits at its own Vgs
    while the output devices sit near the control node, and on 0.5 um devices that
    difference is worth more than half the current. Measured over 27 corners the
    pump delivers 1.16 - 2.26 uA, and it tracks rail and process rather than being
    a constant at all. A loop gain out by that factor moves the crossover by the
    same factor, so the phase margin computed from 1 uA describes a different loop.
    T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
2026-09-18 datasheet: phase margin over every control segment, not the steepest one
    pvt_kvco returned one slope per corner, taken at the two lowest control points,
    because the worst case for loop stability was assumed to be the highest Kvco.
    A type-II loop loses phase margin at BOTH ends of the gain spread: high Kvco
    pushes the crossover up toward the filter pole, low Kvco lets it fall back
    toward the zero. Keeping only the steep pair discarded exactly the segments
    that fail, and no output said a segment had been dropped.
    Every consecutive pair is now a corner in its own right, and the label carries
    the control span because a corner no longer names one number.
2026-09-18 datasheet: derive the loop from what was measured, on both of its gain terms
    Icp stops being a constant. It was 1e-6 with a comment saying mirrored 1:1
    from the harness reference; the pump delivers 1.16 - 2.26 uA and tracks rail
    and process. Each control segment now carries the pump current measured at the
    same corner, because multiplying one corners Kvco by another corners Icp -- or
    by a number -- is not a corner at all. With no charge-pump sweep on disk this
    returns nothing rather than falling back to the nominal reference: a fallback
    is how a figure gets published for a loop whose gain was assumed, and it reads
    exactly like a figure that was measured.
    The control range stops being the ra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
2026-09-18 pll: the re-sized loop filter, and the 250 nA bias reference it is sized for
    Rz 80.77k -> 125.09k (l 56.9u -> 88u, measured on the PDK at all three rhigh
    corners), Cz 5.11p -> 8.65p (63x63 -> 82x82 um), Cp 0.417p -> 0.33p (18x18 ->
    16x16 um), and the benches take the harness 250 nA rail in place of the 1 uA one.
    Why the bias moved: required capacitance scales with the pump current, and the
    pump current was never measured. From the 1 uA reference it delivers 1.16-2.26
    uA, so the loop ran at about twice the gain its filter was designed for -- 39.8
    deg of phase margin at N=8 and a crossover at 2.00x the f_ref/10 bound. Holding
    45 deg at that current costs 15,908 um2 of capacitor; off the 250 n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
    [loop_filter.sch]
2026-09-18 sim: cover the bottom of the specified band, and measure acquisition per corner
    TWO GAPS, and the second was hidden by the first.
    The control sweep started at 0.5 x vdd. The loop settles where f_out = N x
    f_ref, so the lowest output the part can be asked for is 8 x 16 MHz = 128 MHz --
    and on a 1.50 V rail 0.5 x vdd is 0.75 V, where the ring is already past 400
    MHz. The whole bottom half of the specified band sat below the sweep, so no
    phase margin was ever computed for it. Now 0.35 to 1.0 x vdd, 243 points.
    Acquisition was measured at one corner and published as the block figure. That
    was defensible at 4 us against a 20 us limit: no corner spread closes a 5x gap.
    Sizing the loop to respect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
2026-09-18 doc: slot 6, two pins, and the bias reference the loop is actually sized for
    Slot allocation recorded where the pin ask was: slot 6, two pins, which is
    exactly ref in and vco_out out, so the pads listed are the allocation and not a
    request.
    And the Icp claim corrected. The doc said Icp = 1 uA matches what the harness
    provides, mirrored 1:1. The mirror is 1:1 in WIDTH, not in drain-source
    voltage: measured over 27 corners the pump delivered 1.16-2.26 uA from that
    reference. The block now takes the 250 nA rail instead, measuring 0.31-0.63 uA,
    because required filter capacitance scales with the pump current - 45 degrees
    costs 15,908 um2 of capacitor at the 1 uA reference against 6,980 um2 here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
2026-09-19 doc: write down which rail is which, and correct the supply corner set
    1.2 V IS THE HARD INPUT. The block runs entirely from the core/digital rail --
    ring, PFD, charge pump and divider are all lv devices and 1.2 V standard cells.
    3.3 V is the PALLET supply, the only one the harness README documents, and this
    block does not use it at all; the capless LDO in the same programme does.
    Three traps written down because each has caught us:
    - the harness bandgap is ~1.2 V and is a REFERENCE, not a supply. It is the
    only 1.2 V string in the harness repo and it lives in the bias generator.
    - openframe_project_wrapper labels its ports Core 5.0V supply and Core 3.3V
    supply. That is stale Carave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
2026-09-19 doc: publish the measured numbers, on the rail the block is specified for
    RAILS_SPEC lands in the derivation: 1.08/1.20/1.32 V, the PDK own core-rail
    family for a 1.2 V supply, judged rather than mixed with the 0.98/1.50 V sweep
    which is kept for comparison only.
    Measured, and all seven figures pass datasheet.py --check:
    phase margin N=8 51.3 deg (45 min) PASS
    phase margin N=16 51.2 deg (45 min) PASS
    lock time 16.0 us (20 max) PASS
    tuning range 115.4 - 735.3 MHz
    guaranteed ceiling 352.6 MHz (800 goal) short
    crossover / (fref/10) 1.20 (1.0 max) over
    charge-pump current 0.31-0.63 uA measured
    The goal column is relabelled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
2026-09-19 doc: lead with the summary table, and publish acquisition per corner
    The measured/goal table moves to the top of the README: it is the fastest way
    to see what this block does, and it was sitting below two sections of prose.
    Acquisition becomes a derived, checked figure rather than a sentence. The
    headline lock time is ONE corner and it is not the worst one - the bench models
    the ring behaviourally at a single process, temperature and rail. That was
    defensible at 4 us against a 20 us limit, since no corner spread closes a 5x
    gap; bringing the loop inside its own f_ref/10 bandwidth bound spent most of
    that margin, so the spread is now the result.
    tt/27/1.20 16 us
    ss/110/1.08 16 us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
2026-09-19 doc: name the supply row for the harness net it arrives on
    Supply was ambiguous in a block that sits in a slot with two of them. The row
    is now Digital supply (vccd) input: vccd is the harness core/digital rail, it
    arrives on this block vdd port, and it is explicitly not the 3.3 V pallet
    supply, which this block does not connect to at all.
2026-10-04 Wired views of all eight cells, drawn from the netgraph and proven equal by xschem
    The generated cells connect most terminals by lab_pin name. tools/sch_bridge.py
    draws those same-name connections as wires without moving a device: it builds
    connectivity the way the netlister does, maze-routes between fragments that share
    a name while refusing any route that would touch another net, keeps one label
    only where no wired port names the net, and trims a wire only beyond its last
    connection. That rule holds for this repo (label on the terminal, real route
    leaving it) as well as the LDO (label at the end of a stub), where a rule over
    wire shape had severed nets in all eight cells.
    tools/sch_equiv.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
    [charge_pump_wired.sch, cs_inv_wired.sch, divn_wired.sch, loop_filter_lownoise_wired.sch, loop_filter_wired.sch, pfd_wired.sch, pll_rosc_wired.sch, rosc_vco_wired.sch]
2026-10-04 Move the schematic wiring tools out of the IP repo
    sch_bridge.py and sch_equiv.sh are design tooling rather than shipped IP, and
    they now serve more than this block, so their one copy lives with the rest of
    the internal flow. Two copies would drift. The wired views and their xschem
    equivalence are unchanged; the doc now describes how they were made and
    checked, rather than naming a script path this repo no longer carries.
2026-10-04 floorplan: place the block in slot 6, from measured footprints, checked by routing rules
    tools/area_budget.py measures every device the way the LDO does, with PDK
    PyCells for transistors, resistors and capacitors, and the PDK LEF for standard
    cells. All 59 generate: 7,678 um2, 5.2 % of the 537.15 x 273 um slot, and the
    loop filter is 93 % of it.
    Area is therefore not the constraint, and tools/floorplan.py checks routing
    instead. vctrl is short at both ends (filter to pump 6 um, to ring bias 30 um).
    The PFD abuts the pump, so up/dn are short and equal. Standard cells stay at
    least 40 um from the filter, with the pump between. The ring output end is
    within 100 um of the vco_out pad. A channel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
2026-10-04 floorplan: placement map for the slot GDS, and the rails are TopMetal1
    Adds PLACE and PACK: which region each netlist instance goes in, with the guard-ring
    inset, the Rz fold height and the ring kept in netlist order so its stages stay in
    sequence. With them all 59 devices place, and the placement-only GDS
    (chipalooza tools/slot_gds.py) is DRC-clean.
    The rails were described as metal5, which is magic naming. This PDK has no Metal5:
    the wrapper GDS has them on TopMetal1.
2026-10-04 floorplan: place Rz straight, because LVS reads a folded rhigh differently
    The PDK rhigh serpentine (b bends) extracts as per-segment l plus bends, so a
    folded Rz (l 19.3 per segment) failed LVS against the schematic l 88. Folding
    it would need b and a per-segment l in the schematic, and a re-simulation for
    the bend resistance. Straight, it is 1.40 x 89.22 um and fits the filter
    region. Found by LVS on the first routed slot GDS.
2026-10-04 README: placed, routed, DRC- and LVS-clean -- and what holds the layout back
    The status line said schematic. A routed slot layout now exists, with 0 DRC
    violations and an LVS match in strict port mode on the PDK KLayout decks. The
    README says so, records the 6 antenna markers on ref with why they should clear
    in chip context, and lists what keeps the layout out of gds/: the unassigned
    control bits, the vco_out pad decision, MOM capacitor extraction at about twice
    the model (which blocks post-layout simulation of the loop), and rails routed
    as ordinary nets. It also records what routing needed that the PDK cells lack.
2026-10-08 floorplan: fold the ring, one column per stage, each loaded by its own inverter
    The shelf packer laid the seven stages in one row and wrapped it inside X6:
    n7 ran 110 um back to X7 and the extracted ring was 30 % slow. X1-X4 now run
    left to right, X5-X7 back above them, so every ring wire spans about one
    column. Placed with chipalooza slot_gds.py groups mode; routed DRC 0, LVS match.
2026-10-08 README: post-layout status -- first check failed, ring folded (319.7 vs 296 MHz), re-run in progress; vco_out divider decided; MOM pin note corrected; IHP-Open-PDK#1267
2026-10-08 datasheet: lock time needs a settled witness, not the last sample agreeing with itself
    The old rule took the first sample within 1 % of the LAST sample, so a loop still slewing
    at the window end read as locked at the window end (post-layout ss/-40/1.08: 24.0 us from
    a 24 us window while vctrl climbed 0.73 -> 0.81 -> 0.89 V). settle_time() now needs every
    sample from the lock time on within tolerance AND at least one sample before the last;
    otherwise the run is not settled and reports as such (Fail). Published figures unchanged
    (--check ok); the 24 us post-layout run now reads not settled, the 48 us run 24 us.
2026-10-08 post-layout datasheet (pll_rosc_pex.md) and README post-layout column, checked by --check
    datasheet.py: --source/--tree/--pexjson write a sheet from a post-layout run (Cz/Cp as
    extracted; typical lock from the per-corner bench at tt/27/1.20, since tb_pll_lock carries
    the schematic VCO model). --check also verifies the README post-layout column against the
    generated pex sheet (mutation-checked). Post-layout: PM 56.1/46.0 deg PASS, lock 18 us typ,
    24 us worst corner, output 194.6-559.7 MHz typ, 263.9 MHz guaranteed over PVT.
2026-10-18 pfd: antenna diodes on ref and porb (D3)
    ref and porb arrive from wrapper pins hundreds of um away and climb to
    TopMetal1; the gates they drive (Xup CLK, Xand B) failed Ant.b on Metal3,
    Metal4 and TopMetal1 (12 markers). One sg13cmos5l_antennanp beside each
    gate, placed in the PFD region. Routed slot 6: antenna 0, DRC 0, LVS match
    (block alone and in slot). Wired view proven equal by sch_equiv.sh.
2026-10-18 doc/figures: presentation circuit figures (cirfig_gen), checked net by net against the xschem schematics
    One SVG per circuit, drawn with cirfig_gen. Each figure is a description of the
    schematic, not a source of truth: README.md carries the per-pin check table
    against the xschem netlist and lists every simplification.
2026-10-18 gds: slot_6.gds and the standalone block cell sg13cmos5l_vyges_ip__pll_rosc
    The block is its own layout cell (prBoundary, pins named by its ports);
    slot_6 instances it once and stubs each used wrapper pin to it. Both: DRC 0,
    antenna 0, LVS match, wrapper keepouts clear.
2026-10-18 gds: subcells renamed with a block-unique prefix
    The harness reads every project GDS into one magic session before placing
    any; same-named subcells (PyCell variants such as rhigh$6, nmos$7, via_stack)
    collided at read time in the 2026-10-18 test build. Only the block cell and
    slot_N keep their names. Re-checked on these files: DRC 0, antenna 0,
    keepouts clear, LVS as before.
2026-10-18 gds: written without the $$$CONTEXT_INFO$$$ cell (the last read-time cell collision in the harness)
    Re-checked on these files: DRC 0, antenna 0, keepouts clear, LVS as before.
2026-10-18 README: layout handed off (block cell + slot_6 in gds/), antenna diodes, circuit figures
    The top-level figure replaces the old block diagram, whose numbers were stale
    (lock ~5 us, Cz 9.21 pF). Post-layout table marked as the previous route while
    the check re-runs on the re-routed block. Datasheet regenerated: unchanged;
    --check passes.
2026-10-18 sim: include the PDK diode models in the lock and charge-pump benches
    The PFD antenna diodes (sg13cmos5l_antennanp) are dpantenna subcircuits from
    diodes.lib. Without the include, the lock bench stopped at parse with
    unknown subckt.
2026-10-19 sim: antenna-diode model copy with the n-diode transit time zeroed
    The PDK dantenna (darea: tt 700 ns behind rs 219 kohm) cannot be integrated
    under a clock edge: the tt lock transient aborted at 8.8 ns with Timestep too
    small on its internal node, reproduced with a pulse source and the diode alone.
    tt is forward diffusion charge; these diodes stay reverse-biased, so zeroing it
    changes no physics. sim/diodes_rev.sh writes the copy and fails unless exactly
    two model lines change.
2026-10-19 sim/diodes_rev.sh: link the upstream report (IHP-Open-PDK#1288)
2026-10-19 post-layout re-run on the handed-off block; antenna-diode model copy drops rs too
    Post-layout (re-routed block cell): PM 55.8 deg (N=8) / 46.2 (N=16), tuning
    197.5-565.4 MHz typical, lock 18 us typical and 24 us at ss/-40C/1.08V.
    Post-layout datasheet regenerated; README post-layout column and open items.
    diodes_rev.sh now removes the n-diode series resistance as well as its transit
    time: tt=0 alone still let the full lock bench abort on the PFD flop at 13-21
    us. With both removed it completes and agrees with the same bench run without
    the diodes to 0.8 mV of vctrl at every sample (IHP-Open-PDK#1288).
2026-10-19 docs: antenna-diode abort root cause is the soft-breakdown fit (IHP-Open-PDK#1288 reply); workaround unchanged
2026-10-19 sim/diodes_rev.sh: state only what was measured about the upstream breakdown fix
2026-10-26 Supply grid for the PLL, and the PFD D inputs tied high through a tie cell
    vdd and vss were routed as signals at minimum width from the left-edge pins and
    reached TopMetal1 through one TopVia1 each (layout review 2026-10-22: one Metal4
    run was about 60 ohm). floorplan.py now carries STRAPS: a 28 um TopMetal1 bar from
    each pin to a spine beside the circuits, 22 interdigitated Metal4 + TopMetal1
    fingers over the divider, pump, PFD and ring (8250 TopVia1), and a drawn via
    stack from every supply terminal to its nearest finger. strap_check() bounds the
    pin-to-farthest-point resistance (vss 0.92, vdd 1.19 ohm at max sheet R) and fails
    on slit-width, spacing and MOM-cap overlap; each check fires o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
2026-10-26 Guard rings: p+ ring per region, double ring (n+ in NWell + p+) for the pump and the VCO
    Ridha construction (0.70 um, 2 Cont rows at 0.34 um pitch). Slot 6: DRC 0,
    antenna 0, LVS match (block and slot), keepouts 0.
2026-10-26 Compacted floorplan: regions sized to contents, cluster at the pad edge, ring fold mirrored
    Output end (X1/X7/Xtap/Xbuf) faces vco_out (99 um, was ~230 um from Xbuf);
    bias column stays by the filter (vctrl 28 um). Regions 11.5 % of the slot
    (was ~22 %). Grid 16 fingers, 0.92/1.19 ohm. Slot 6: DRC 0, antenna 0,
    LVS match, keepouts 0.
2026-10-26 PFD schematic: draw the tie-high cell (vyges_tiehi art in sym_art.json) and D on dhi
2026-10-26 Schematics: charge pump in titled groups (up inverter, bias mirror, output stack), output right, rails top/bottom; no doubled net labels; sch2svg draws group frames. xschem netlists identical (sch_eq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
2026-10-26 Schematics in titled groups, inputs on wires from the left, outputs right, rails top/bottom: PFD (flops, reset, antenna diodes), divider (ripple chain, tap select, toggle feedback drawn), VCO (bias, 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
2026-10-26 gds: the layout-refine layout (grid, guard rings, compaction, mirrored ring fold; built from 9f9acc4). DRC 0, antenna 0, keepouts 0, LVS match. main keeps the taped-out GDS
2026-11-09 gds: block GDS min-area fix (206 Metal2/Metal3 islands grown by chipalooza tools/slot_minarea.py, 0 refused); full IHP rule set incl. maximal deck now 0 on block and slot. slot_6.gds is unchanged (Ti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
